ema-g72/Arduino_Canon_IR/(commit log)

2025-02-27 Added circuit schematic
2025-02-27 Moved sketch in a folder, added breadboard schematic
